shanshili/LiDAR-3D-Reconstructor/readme.assets/image-20230510172401359.png

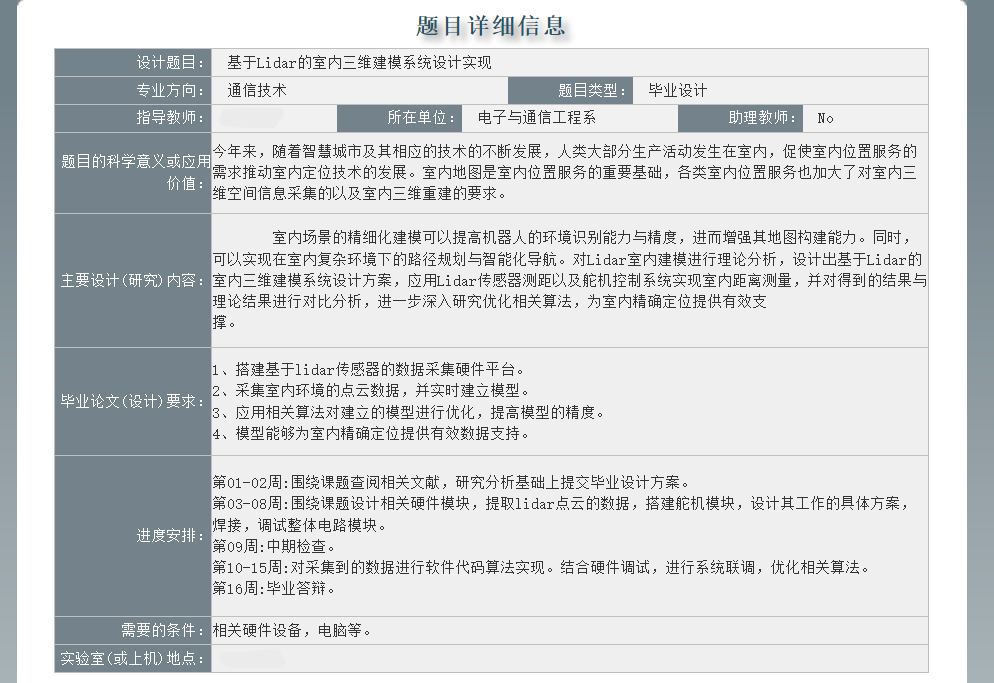
readme.assets/image-20230510172401359.png
