shanshili/LiDAR-3D-Reconstructor/readme.assets/IMG_20230526_222045.jpg

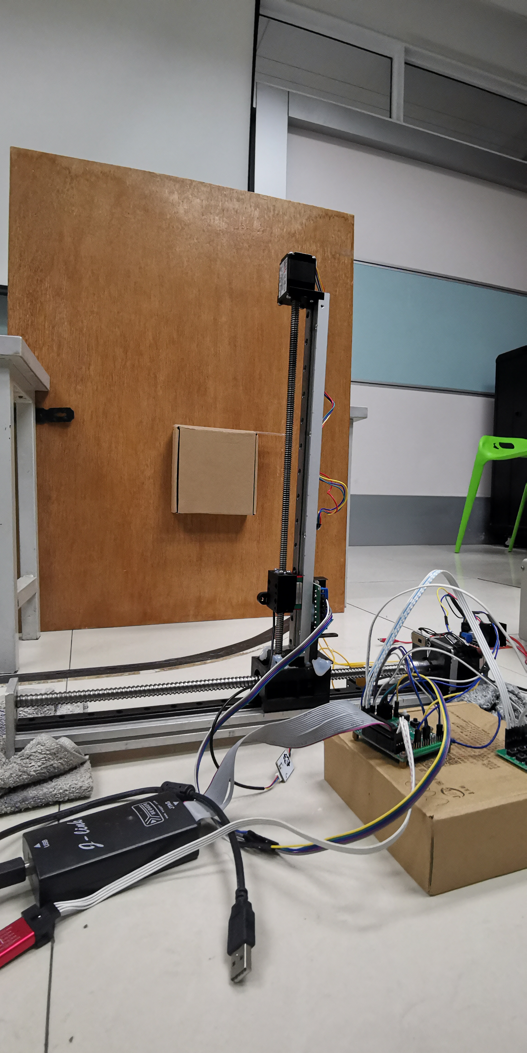
readme.assets/IMG_20230526_222045.jpg
