shanshili/LiDAR-3D-Reconstructor/readme.assets/IMG_20230601_145232-01.jpeg

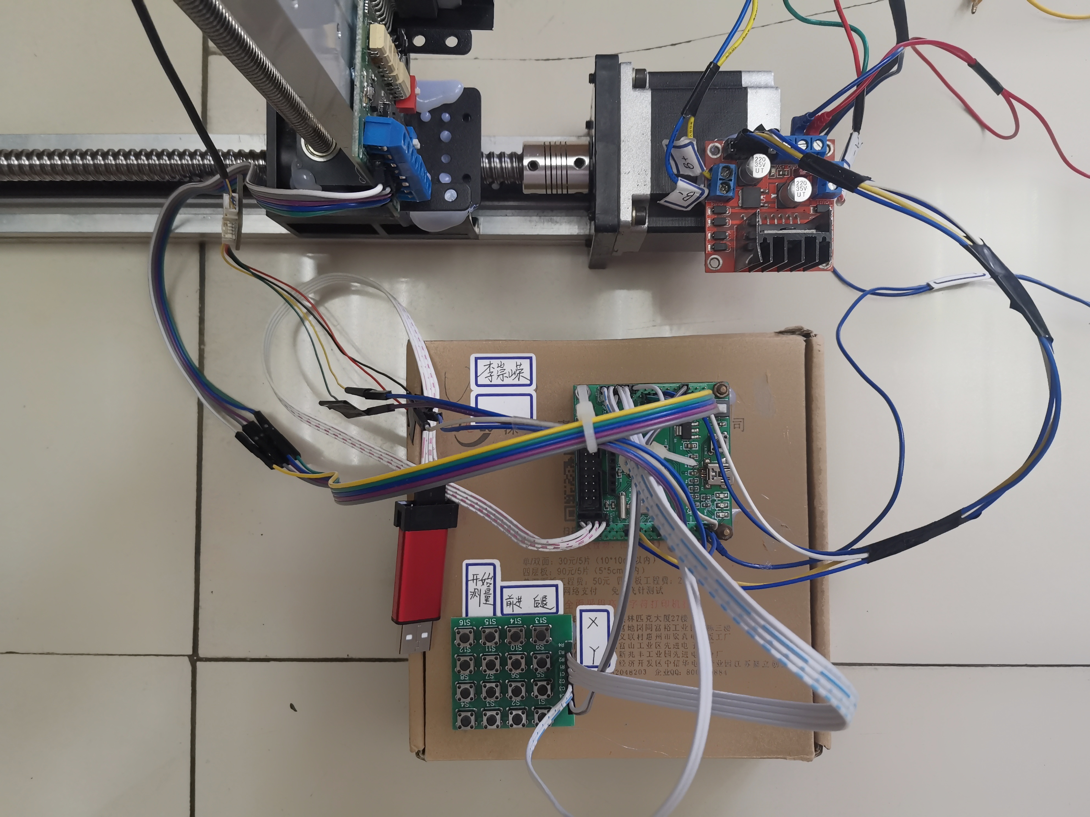
readme.assets/IMG_20230601_145232-01.jpeg
