shanshili/LiDAR-3D-Reconstructor/readme.assets/IMG_20230601_145245-01.jpeg

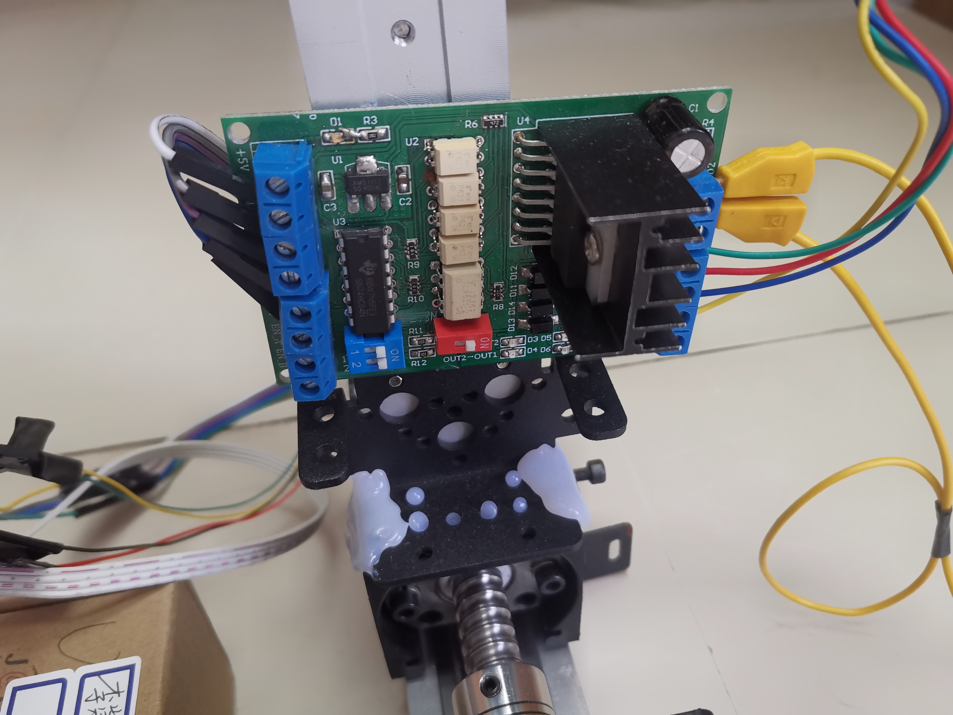
readme.assets/IMG_20230601_145245-01.jpeg
