shanshili/LiDAR-3D-Reconstructor/readme.assets/IMG_20230602_094755-01.jpeg

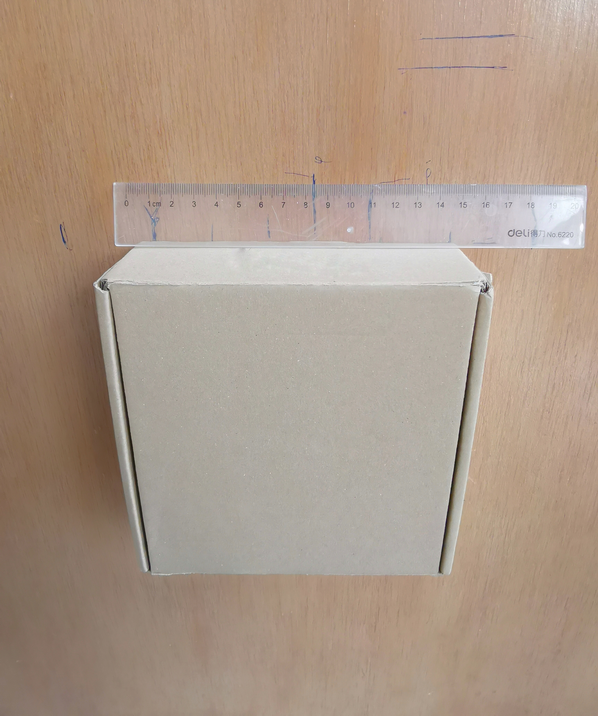
readme.assets/IMG_20230602_094755-01.jpeg
