shanshili/LiDAR-3D-Reconstructor/readme.assets/IMG_20230602_095030-01.jpeg

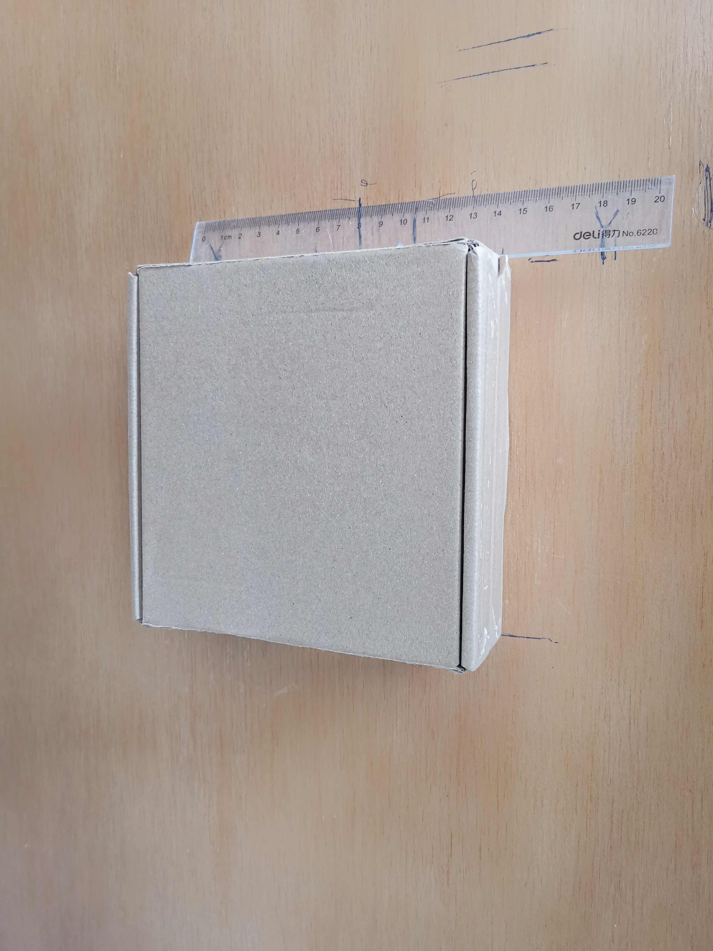
readme.assets/IMG_20230602_095030-01.jpeg
