shanshili/LiDAR-3D-Reconstructor/readme.assets/IMG_20230604_115848-01.jpeg

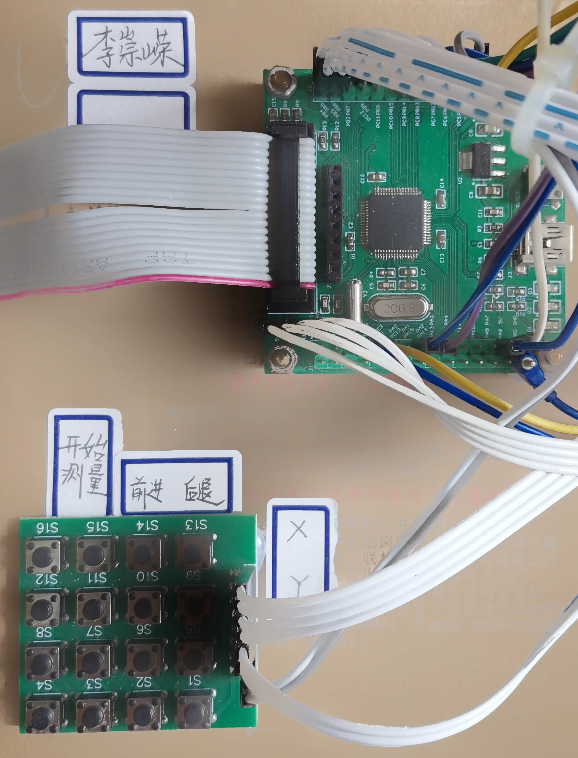
readme.assets/IMG_20230604_115848-01.jpeg
