shanshili/LiDAR-3D-Reconstructor/readme.assets/mmexport1686489631616.png

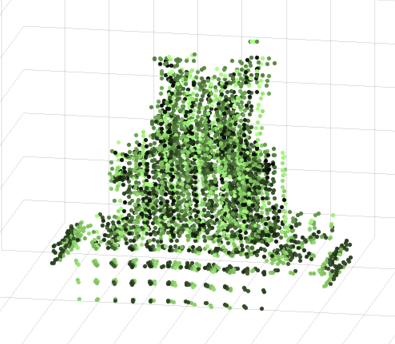
readme.assets/mmexport1686489631616.png
