shanshili/LiDAR-3D-Reconstructor/readme.assets/mmexport1686489634088.png

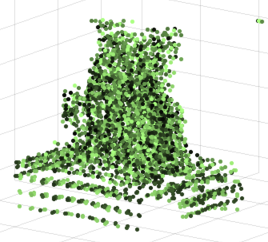
readme.assets/mmexport1686489634088.png
