shanshili/LiDAR-3D-Reconstructor/readme.assets/mmexport1686489636348.png

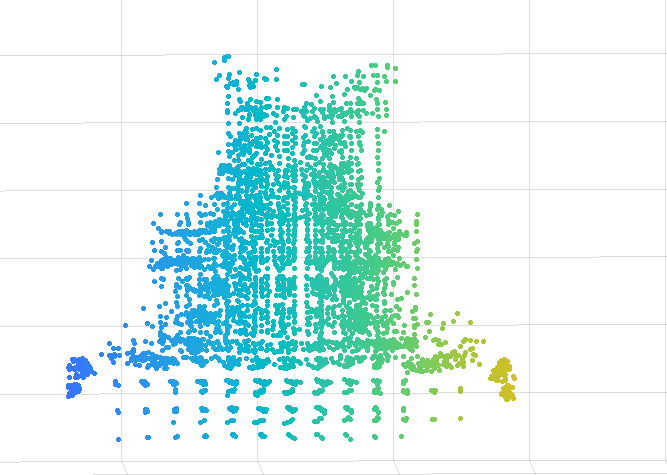
readme.assets/mmexport1686489636348.png
