shanshili/LiDAR-3D-Reconstructor/方案Ⅱ 9三系统联调-调整优先级-舵机采样稀疏 + MONITOR (P)/SYSTEM/usart/usart.c

#include "sys.h"
#include "usart.h"	  
#include "main.h"
#include "wit_c_sdk.h"

u32 Monitor_Distance;
u32 A_Distance;
u32 A_statue;
////////////////////////////////////////////////////////////////////////////////// 	 
//如果使用ucos,则包括下面的头文件即可.
#if SYSTEM_SUPPORT_OS
#include "includes.h"					//ucos 使用	  
#endif
//////////////////////////////////////////////////////////////////////////////////	 
//本程序只供学习使用，未经作者许可，不得用于其它任何用途
//ALIENTEK STM32开发板
//串口1初始化		   
//正点原子@ALIENTEK
//技术论坛:www.openedv.com
//修改日期:2012/8/18
//版本：V1.5
//版权所有，盗版必究。
//Copyright(C) 广州市星翼电子科技有限公司 2009-2019
//All rights reserved
//********************************************************************************
//V1.3修改说明 
//支持适应不同频率下的串口波特率设置.
//加入了对printf的支持
//增加了串口接收命令功能.
//修正了printf第一个字符丢失的bug
//V1.4修改说明
//1,修改串口初始化IO的bug
//2,修改了USART_RX_STA,使得串口最大接收字节数为2的14次方
//3,增加了USART_REC_LEN,用于定义串口最大允许接收的字节数(不大于2的14次方)
//4,修改了EN_USART1_RX的使能方式
//V1.5修改说明
//1,增加了对UCOSII的支持
////////////////////////////////////////////////////////////////////////////////// 	  
 

//////////////////////////////////////////////////////////////////
//加入以下代码,支持printf函数,而不需要选择use MicroLIB	  
#if 1
#pragma import(__use_no_semihosting)             
//标准库需要的支持函数                 
struct __FILE 
{ 
	int handle; 

}; 

FILE __stdout;       
//定义_sys_exit()以避免使用半主机模式    
void _sys_exit(int x) 
{ 
	x = x; 
} 
//重定义fputc函数 
int fputc(int ch, FILE *f)
{      
	while((USART1->SR&0X40)==0);//循环发送,直到发送完毕   
    USART1->DR = (u8) ch;      
	return ch;
}
#endif 

/*使用microLib的方法*/
 /* 
int fputc(int ch, FILE *f)
{
	USART_SendData(USART1, (uint8_t) ch);

	while (USART_GetFlagStatus(USART1, USART_FLAG_TC) == RESET) {}	
   
    return ch;
}
int GetKey (void)  { 

    while (!(USART1->SR & USART_FLAG_RXNE));

    return ((int)(USART1->DR & 0x1FF));
}
*/
 
#if EN_USART1_RX   //如果使能了接收
//串口1中断服务程序
//注意,读取USARTx->SR能避免莫名其妙的错误   	
u8 USART_RX_BUF[USART_REC_LEN];     //接收缓冲,最大USART_REC_LEN个字节.
//接收状态
//bit15，	接收完成标志
//bit14，	接收到0x0d
//bit13~0，	接收到的有效字节数目
u16 USART_RX_STA=0;       //接收状态标记	  
  
void uart_init(u32 bound){
  //GPIO端口设置
  GPIO_InitTypeDef GPIO_InitStructure;
	USART_InitTypeDef USART_InitStructure;
	NVIC_InitTypeDef NVIC_InitStructure;
	 
	RCC_APB2PeriphClockCmd(RCC_APB2Periph_USART1|RCC_APB2Periph_GPIOA, ENABLE);	//使能USART1，GPIOA时钟
  
	//USART1_TX   GPIOA.9
  GPIO_InitStructure.GPIO_Pin = GPIO_Pin_9; //PA.9
  GPIO_InitStructure.GPIO_Speed = GPIO_Speed_50MHz;
  GPIO_InitStructure.GPIO_Mode = GPIO_Mode_AF_PP;	//复用推挽输出
  GPIO_Init(GPIOA, &GPIO_InitStructure);//初始化GPIOA.9
   
  //USART1_RX	  GPIOA.10初始化
  GPIO_InitStructure.GPIO_Pin = GPIO_Pin_10;//PA10
  GPIO_InitStructure.GPIO_Mode = GPIO_Mode_IN_FLOATING;//浮空输入
  GPIO_Init(GPIOA, &GPIO_InitStructure);//初始化GPIOA.10  

  //Usart1 NVIC 配置
  NVIC_InitStructure.NVIC_IRQChannel = USART1_IRQn;
	NVIC_InitStructure.NVIC_IRQChannelPreemptionPriority=2 ;//抢占优先级3
	NVIC_InitStructure.NVIC_IRQChannelSubPriority = 2;		//子优先级3
	NVIC_InitStructure.NVIC_IRQChannelCmd = ENABLE;			//IRQ通道使能
	NVIC_Init(&NVIC_InitStructure);	//根据指定的参数初始化VIC寄存器
  
   //USART 初始化设置

	USART_InitStructure.USART_BaudRate = bound;//串口波特率
	USART_InitStructure.USART_WordLength = USART_WordLength_8b;//字长为8位数据格式
	USART_InitStructure.USART_StopBits = USART_StopBits_1;//一个停止位
	USART_InitStructure.USART_Parity = USART_Parity_No;//无奇偶校验位
	USART_InitStructure.USART_HardwareFlowControl = USART_HardwareFlowControl_None;//无硬件数据流控制
	USART_InitStructure.USART_Mode = USART_Mode_Rx | USART_Mode_Tx;	//收发模式

  USART_Init(USART1, &USART_InitStructure); //初始化串口1
  //USART_ITConfig(USART1, USART_IT_RXNE, ENABLE);//开启串口接受中断
  USART_Cmd(USART1, ENABLE);                    //使能串口1 

}
/*
void USART1_IRQHandler(void)                	//串口1中断服务程序
	{
	u8 Res;
#if SYSTEM_SUPPORT_OS 		//如果SYSTEM_SUPPORT_OS为真，则需要支持OS.
	OSIntEnter();    
#endif
	if(USART_GetITStatus(USART1, USART_IT_RXNE) != RESET)  //接收中断(接收到的数据必须是0x0d 0x0a结尾)
		{
		Res =USART_ReceiveData(USART1);	//读取接收到的数据
		
		if((USART_RX_STA&0x8000)==0)//接收未完成
			{
			if(USART_RX_STA&0x4000)//接收到了0x0d
				{
				if(Res!=0x0a)USART_RX_STA=0;//接收错误,重新开始
				else USART_RX_STA|=0x8000;	//接收完成了 
				}
			else //还没收到0X0D
				{	
				if(Res==0x0d)USART_RX_STA|=0x4000;
				else
					{
					USART_RX_BUF[USART_RX_STA&0X3FFF]=Res ;
					USART_RX_STA++;
					if(USART_RX_STA>(USART_REC_LEN-1))USART_RX_STA=0;//接收数据错误,重新开始接收	  
					}		 
				}
			}   		 
     } 
#if SYSTEM_SUPPORT_OS 	//如果SYSTEM_SUPPORT_OS为真，则需要支持OS.
	OSIntExit();  											 
#endif
} 
*/
void uart1send(unsigned char p_data)
{	
		while(USART_GetFlagStatus(USART1, USART_FLAG_TXE) == RESET);
		USART_SendData(USART1, p_data);		
	  while(USART_GetFlagStatus(USART1, USART_FLAG_TC) == RESET);
}
#endif	


#if EN_USART2_RX //如果使能了串口2接收

u8 USART2_RX_BUF[USART_REC_LEN];     //串口2接收缓冲,最大USART_REC_LEN个字节.
u16 USART2_RX_STA=0;       //串口2接收状态标记

void uart2_init(u32 bound)
{
    
    
	//GPIO端口设置
	GPIO_InitTypeDef GPIO_InitStructure;
	USART_InitTypeDef USART_InitStructure;
	NVIC_InitTypeDef NVIC_InitStructure;

	RCC_APB1PeriphClockCmd(RCC_APB1Periph_USART2|RCC_APB2Periph_GPIOA, ENABLE);	//使能USART2，GPIOA时钟

	//USART2_TX   GPIOA.2
	GPIO_InitStructure.GPIO_Pin = GPIO_Pin_2; //PA.2
	GPIO_InitStructure.GPIO_Speed = GPIO_Speed_50MHz;
	GPIO_InitStructure.GPIO_Mode = GPIO_Mode_AF_PP;	//复用推挽输出
	GPIO_Init(GPIOA, &GPIO_InitStructure);//初始化GPIOA.2

	//USART2_RX	  GPIOA.3初始化
	GPIO_InitStructure.GPIO_Pin = GPIO_Pin_3;//PA3
	GPIO_InitStructure.GPIO_Mode = GPIO_Mode_IN_FLOATING;//浮空输入
	GPIO_Init(GPIOA, &GPIO_InitStructure);//初始化GPIOA.3  

	//Usart2 NVIC 配置
	NVIC_InitStructure.NVIC_IRQChannel = USART2_IRQn;
	NVIC_InitStructure.NVIC_IRQChannelPreemptionPriority=1 ;//抢占优先级2
	NVIC_InitStructure.NVIC_IRQChannelSubPriority = 1;		//子优先级2
	NVIC_InitStructure.NVIC_IRQChannelCmd = ENABLE;			//IRQ通道使能
	NVIC_Init(&NVIC_InitStructure);	//根据指定的参数初始化VIC寄存器

	//USART 初始化设置

	USART_InitStructure.USART_BaudRate = bound;//串口波特率
	USART_InitStructure.USART_WordLength = USART_WordLength_8b;//字长为8位数据格式
	USART_InitStructure.USART_StopBits = USART_StopBits_1;//一个停止位
	USART_InitStructure.USART_Parity = USART_Parity_No;//无奇偶校验位
	USART_InitStructure.USART_HardwareFlowControl = USART_HardwareFlowControl_None;//无硬件数据流控制
	USART_InitStructure.USART_Mode = USART_Mode_Rx | USART_Mode_Tx;	//收发模式

  USART_Init(USART2, &USART_InitStructure); //初始化串口2
  USART_ITConfig(USART2, USART_IT_RXNE, ENABLE);//开启串口接受中断
  USART_Cmd(USART2, ENABLE);                    //使能串口2

}

void USART2_IRQHandler(void)
{
      static u8 seri_count=0;
      u16 check_sum=0;   
      u8 i;
      static u8 flag=0; 
      if(USART_GetITStatus(USART2, USART_IT_RXNE) != RESET)
     {                                                        
				 if(USART_ReceiveData(USART2) == 0x57) 
				{
					 flag = 1;
				}                       
				if(flag)
			 {        
					 USART2_RX_BUF[seri_count++] =USART_ReceiveData(USART2); 						
					 if(seri_count == 16)        
					 {
							 if(USART2_RX_BUF[0]==0x57 ) 
							 {
									for( i = 0; i < 16-1; i++)
								 {
										check_sum += USART2_RX_BUF[i];             
								 }
								 if((check_sum & 0x00ff)== USART2_RX_BUF[15]) 
								{
									 //if(USART2_RX_BUF[11] == 0)  // 测量距离有效
									if((USART2_RX_BUF[11] != 14) && (USART2_RX_BUF[11] != 255) )   // 测量距离有效
									{		
											A_Distance = (USART2_RX_BUF[10] <<16| USART2_RX_BUF[9]<<8|USART2_RX_BUF[8]); 
											A_statue = USART2_RX_BUF[11];
									}
								}
									seri_count = 0; 
									flag=0; 
							}                                                
					}        
       }
   }
}

#endif	


#if EN_USART3_RX //如果使能了串口3接收

u8 USART3_RX_BUF[USART_REC_LEN];     //串口2接收缓冲,最大USART_REC_LEN个字节.
u16 USART3_RX_STA=0;       //串口2接收状态标记

void uart3_init(u32 bound)
{      
	//GPIO端口设置
	GPIO_InitTypeDef GPIO_InitStructure;
	USART_InitTypeDef USART_InitStructure;
	NVIC_InitTypeDef NVIC_InitStructure;

	RCC_APB1PeriphClockCmd(RCC_APB1Periph_USART3|RCC_APB2Periph_GPIOB, ENABLE);	//使能USART3，GPIOB时钟

	//USART3_TX   GPIOB.10
	GPIO_InitStructure.GPIO_Pin = GPIO_Pin_10; 
	GPIO_InitStructure.GPIO_Speed = GPIO_Speed_50MHz;
	GPIO_InitStructure.GPIO_Mode = GPIO_Mode_AF_PP;	//复用推挽输出
	GPIO_Init(GPIOA, &GPIO_InitStructure);//初始化

	//USART3_RX	  GPIOB.11
	GPIO_InitStructure.GPIO_Pin = GPIO_Pin_11;
	GPIO_InitStructure.GPIO_Mode = GPIO_Mode_IN_FLOATING;//浮空输入
	GPIO_Init(GPIOA, &GPIO_InitStructure);//初始化 

	//Usart3 NVIC 配置
	NVIC_InitStructure.NVIC_IRQChannel = USART3_IRQn;
	NVIC_InitStructure.NVIC_IRQChannelPreemptionPriority=1 ;//抢占优先级2
	NVIC_InitStructure.NVIC_IRQChannelSubPriority = 2;		//子优先级2
	NVIC_InitStructure.NVIC_IRQChannelCmd = ENABLE;			//IRQ通道使能
	NVIC_Init(&NVIC_InitStructure);	//根据指定的参数初始化VIC寄存器

	//USART3 初始化设置
	USART_InitStructure.USART_BaudRate = bound;//串口波特率
	USART_InitStructure.USART_WordLength = USART_WordLength_8b;//字长为8位数据格式
	USART_InitStructure.USART_StopBits = USART_StopBits_1;//一个停止位
	USART_InitStructure.USART_Parity = USART_Parity_No;//无奇偶校验位
	USART_InitStructure.USART_HardwareFlowControl = USART_HardwareFlowControl_None;//无硬件数据流控制
	USART_InitStructure.USART_Mode = USART_Mode_Rx | USART_Mode_Tx;	//收发模式

  USART_Init(USART3, &USART_InitStructure); //初始化串口3
  USART_ITConfig(USART3, USART_IT_RXNE, ENABLE);//开启串口接受中断
  USART_Cmd(USART3, ENABLE);                    //使能串口3

}

void USART3_IRQHandler(void)
{
	unsigned char ucTemp;
	if(USART_GetITStatus(USART3, USART_IT_RXNE) != RESET)
	{
		ucTemp = USART_ReceiveData(USART3);		
		WitSerialDataIn(ucTemp);//读取一个byte 	
		USART_ClearITPendingBit(USART3, USART_IT_RXNE);

	}
}
#endif	


#if EN_UART4_RX //如果使能了串口3接收

u8 UART4_RX_BUF[USART_REC_LEN];     //串口2接收缓冲,最大USART_REC_LEN个字节.
u16 UART4_RX_STA=0;       //串口2接收状态标记

void uart4_init(u32 bound)
{      
	//GPIO端口设置
	GPIO_InitTypeDef GPIO_InitStructure;
	USART_InitTypeDef USART_InitStructure;
	NVIC_InitTypeDef NVIC_InitStructure;

	//使能时钟
	RCC_APB1PeriphClockCmd(RCC_APB1Periph_UART4, ENABLE);
	RCC_APB2PeriphClockCmd(RCC_APB2Periph_GPIOC | RCC_APB2Periph_AFIO, ENABLE);
	
	//USART3_TX   GPIOC.10
	GPIO_InitStructure.GPIO_Pin = GPIO_Pin_10; 
	GPIO_InitStructure.GPIO_Speed = GPIO_Speed_50MHz;
	GPIO_InitStructure.GPIO_Mode = GPIO_Mode_AF_PP;	//复用推挽输出
	GPIO_Init(GPIOC, &GPIO_InitStructure);//初始化

	//USART3_RX	  GPIOC.11
	GPIO_InitStructure.GPIO_Pin = GPIO_Pin_11;
	GPIO_InitStructure.GPIO_Mode = GPIO_Mode_IN_FLOATING;//浮空输入
	GPIO_Init(GPIOC, &GPIO_InitStructure);//初始化 

	//Usart3 NVIC 配置
	NVIC_InitStructure.NVIC_IRQChannel = UART4_IRQn;
	NVIC_InitStructure.NVIC_IRQChannelPreemptionPriority=1 ;//抢占优先级2
	NVIC_InitStructure.NVIC_IRQChannelSubPriority = 2;		//子优先级2
	NVIC_InitStructure.NVIC_IRQChannelCmd = ENABLE;			//IRQ通道使能
	NVIC_Init(&NVIC_InitStructure);	//根据指定的参数初始化VIC寄存器

	//USART4 初始化设置
	USART_InitStructure.USART_BaudRate = bound;//串口波特率
	USART_InitStructure.USART_WordLength = USART_WordLength_8b;//字长为8位数据格式
	USART_InitStructure.USART_StopBits = USART_StopBits_1;//一个停止位
	USART_InitStructure.USART_Parity = USART_Parity_No;//无奇偶校验位
	USART_InitStructure.USART_HardwareFlowControl = USART_HardwareFlowControl_None;//无硬件数据流控制
	USART_InitStructure.USART_Mode = USART_Mode_Rx | USART_Mode_Tx;	//收发模式

  USART_Init(UART4, &USART_InitStructure); //初始化串口4
  USART_ITConfig(UART4, USART_IT_RXNE, ENABLE);//开启串口接受中断
  USART_Cmd(UART4, ENABLE);                    //使能串口4//大意了，没改全
	USART_ClearFlag(UART4,USART_FLAG_TC);   

}

void UART4_IRQHandler(void)                    //UART4 Receive Interrupt
{
      static u8 seri_count=0;
      u16 check_sum=0;   
      u8 i;
      static u8 flag=0; 
      if(USART_GetITStatus(UART4, USART_IT_RXNE) != RESET)
     {                                                        
				 if(USART_ReceiveData(UART4) == 0x57) 
				{
					 flag = 1;
				}                       
				if(flag)
			 {        
					 UART4_RX_BUF[seri_count++] =USART_ReceiveData(UART4); 						
					 if(seri_count == 16)        
					 {
							 if(UART4_RX_BUF[0]==0x57 ) 
							 {
									for( i = 0; i < 16-1; i++)
								 {
										check_sum += UART4_RX_BUF[i];             
								 }
								 if((check_sum & 0x00ff)== UART4_RX_BUF[15]) 
								{
									 	//if(UART4_RX_BUF[11] == 0)  // 测量距离有效
									 if((UART4_RX_BUF[11] != 14) && (UART4_RX_BUF[11] != 255) )   // 测量距离有效
											Monitor_Distance = (UART4_RX_BUF[10] <<16| UART4_RX_BUF[9]<<8|UART4_RX_BUF[8]); 
								}
									seri_count = 0; 
									flag=0; 
							}                                                
					}        
       }
   }
}

#endif	
