shanshili/LiDAR-3D-Reconstructor/STM32F1 Monitor XY lidar - JSON/HARDWARE/OLED/OLED.H

#ifndef _OLED_H_
#define _OLED_H_

#include "stm32f10x.h"
 
#define OLED_MODE 0
#define SIZE 8
#define XLevelL		0x00
#define XLevelH		0x10
#define Max_Column	128
#define Max_Row		64
#define	Brightness	0xFF 
#define X_WIDTH 	128
#define Y_WIDTH 	64	  
 
//-----------------OLED IIC端口定义----------------  					   

#define OLED_SCLK_Clr() GPIO_ResetBits(GPIOB,GPIO_Pin_8)//SCL
#define OLED_SCLK_Set() GPIO_SetBits(GPIOB,GPIO_Pin_8)


#define OLED_SDIN_Clr() GPIO_ResetBits(GPIOB,GPIO_Pin_9)//SDA
#define OLED_SDIN_Set() GPIO_SetBits(GPIOB,GPIO_Pin_9)

 		     
#define OLED_CMD  0	//写命令
#define OLED_DATA 1	//写数据

void OLED_ShowChar(u8 x,u8 y,u8 chr,u8 Char_Size);
void OLED_ShowString(u8 x,u8 y,u8 *chr,u8 Char_Size);
void OLED_ShowCHinese(u8 x,u8 y,u8 no);
void  OLED_Show_number(u8 x,u8 y,u8 Char_Size,u8 no );
void OLED_Init(void);
void OLED_Clear(void);// 清屏函数
void OLED_On(void);//更新显示
//void OLED_DrawBMP(unsigned char x0, unsigned char y0,unsigned char x1, unsigned char y1 );
//void DrawBMP();
#endif
