shanshili/LiDAR-3D-Reconstructor/方案Ⅰ 5三系统联调-调整优先级-舵机采样稀疏/HARDWARE/wit_c_sdk/wit_c_sdk.c

#include "wit_c_sdk.h"
#include "REG.h"
#include "usart.h"	

static RegUpdateCb p_WitRegUpdateCbFunc = NULL;
static uint8_t inputdata[11];
static uint32_t inputdatasum = 0;
int16_t sReg[REGSIZE];//传输到主函数

static uint8_t __CaliSum(uint8_t *data, uint32_t len)
{
    uint32_t i;
    uint8_t ucCheck = 0;
    for(i=0; i<len; i++) ucCheck += *(data + i);
    return ucCheck;
}

void WitSerialDataIn(uint8_t ucData)
{
    uint16_t usData[6];//数据字节整理
    uint8_t ucSum;//校验和
	  inputdata[inputdatasum] = ucData;
	  if(inputdata[0] == 0x55)//从协议头开始计数
		{      
			inputdatasum++;	
			if(inputdatasum == 11) //读取了一帧协议
			{
				ucSum = __CaliSum(inputdata, 10);  //判断校验和
				if(ucSum == inputdata[10])         //校验和正确
				{
					if(inputdata[1] == 0x53)
					{
							usData[0] = (short)((short)inputdata[3] << 8) | inputdata[2];//分别读取数据
							usData[1] = (short)((short)inputdata[5] << 8) | inputdata[4];
							usData[2] = (short)((short)inputdata[7] << 8) | inputdata[6];
							usData[3] = (short)((short)inputdata[9] << 8) | inputdata[8];
							memcpy(&sReg[Roll], usData, 8);//!!!一个usData占2个字节
							p_WitRegUpdateCbFunc(Roll, 3); //传感器地址， 读取寄存器个数
					}
					/*
					if(inputdata[1] == 0x50)
					{
						  usData[0] = (int)inputdata[2];
						  usData[1] = (int)inputdata[3];
						  usData[2] = (int)inputdata[4];
						  usData[3] = (int)inputdata[5];
						  usData[4] = (int)inputdata[6];
						  usData[5] = (int)inputdata[7];
				 		  memcpy(&sReg[YYMM], usData, 12);
							p_WitRegUpdateCbFunc(YYMM, 3); //传感器地址， 读取寄存器个数
				  } 
					*/
				}
			}
			if(inputdatasum > 10)
			{
				 inputdatasum = 0;
			}
		}
}


int32_t WitRegisterCallBack(RegUpdateCb update_func)
{
    if(!update_func)return WIT_HAL_INVAL;
    p_WitRegUpdateCbFunc = update_func;
    return WIT_HAL_OK;
}
