shanshili/LiDAR-3D-Reconstructor/(notices)

Notices in the files:
方案Ⅱ 9三系统联调-调整优先级-舵机采样稀疏 + MONITOR (P)/SYSTEM/usart/usart.c:
Copyright(C) ¹ãÖÝÊÐÐÇÒíµç×Ó¿Æ¼¼ÓÐÏÞ¹«Ë¾ 2009-2019
All rights reserved
